twisted-builds-llc/sloppy_holley_flex-over-can/Sloppy_Holley_Flex-over-can/Flex-over-can/production/bom.csv

Designator | Footprint | Quantity | Value | LCSC Part #
C1 | 1206 | 1 | 10uF 50V | C13585
C10, C12, C13, C20, C21, C22, C23, C24, C30, C31, C32, C33 | 0603 | 12 | 100nF | C14663
C11, C7 | 0603 | 2 | 1uF | C15849
C14 | 0603 | 1 | 1nF | C1588
C2, C3 | 0805 | 2 | 0.1uF | C49678
C4 | CP_EIA-3528-21_Kemet-B | 1 | 47uF | C136751
C5 | 0805 | 1 | 1uF 50V | C28323
C6 | 0805 | 1 | 2.2uF 50V | C377773
C8, C9 | 0603 | 2 | 10uF | C19702
D1 | D_SMA | 1 | B160-13-F | C24784
D10, D11, D12, D13, D7 | SOT-23 | 5 | BAT54S | C7420333
D2 | D_SMB | 1 | 1SMB5919BT3G | C70260
D4 | D_SOD-123 | 1 | B5819W | C2943878
D5 | 0603 | 1 | STATUS | C2286
D6 | SOT-23 | 1 | NUP2105L | C284104
F2 | 1812 | 1 | PTC 0.2A 60V | C269125
J2 | USB_C_Receptacle_HRO_TYPE-C-31-M-12 | 1 | USB-C | C165948
JP1 | SolderJumper-2_P1.3mm_Open_RoundedPad1.0x1.5mm | 1 | CAN_TERM
NT1 | NetTie-2_SMD_Pad0.5mm | 1 | NetTie_2
R10, R15, R4, R5, R6 | 0603 | 5 | 10k | C25804
R11 | 0603 | 1 | 120 | C22787
R12, R13 | 0603 | 2 | 5.1k | C23186
R14, R8, R9 | 0603 | 3 | 4.7k | C23162
R20, R21, R22, R23 | 0603 | 4 | 12k | C22790
R24, R25, R26, R27 | 0603 | 4 | 20k | C4184
R30, R31, R32, R33 | 0603 | 4 | 3.3k | C22978
R34, R35, R36, R37 | 0603 | 4 | 100k | C25803
R7 | 0603 | 1 | 1k | C21190
RV1 | D_SMC | 1 | SMDJ24CA | C215903
SW1 | SW_Push_1P1T_XKB_TS-1187A | 1 | BOOT | C318884
U1 | ESP32-C3-WROOM-02 | 1 | ESP32-C3-WROOM-02-N4 | C2934560
U10 | TSSOP-10_3x3mm_P0.5mm | 1 | ADS1115IDGSR | C37593
U11 | SOT-23-5 | 1 | ME6211C33M5G-N | C82942
U2 | TO-263-2 | 1 | L7805ABD2T-TR | C86206
U3 | SOT-223 | 1 | TPS7B6950QDCYRQ1 | C108469
U4, U5, U6, U7 | TO-252-5_TabPin6 | 4 | BTS3256D | C3232337
U8 | SOIC-8_3.9x4.9mm_P1.27mm | 1 | TJA1051T/3 | C38695
U9 | SOT-23-6 | 1 | USBLC6-2SC6 | C7519
