twisted-builds-llc/sloppy_holley_flex-over-can/Sloppy_Holley_Flex-over-can/Flex-over-can/Flex-over-can_3D_file.step

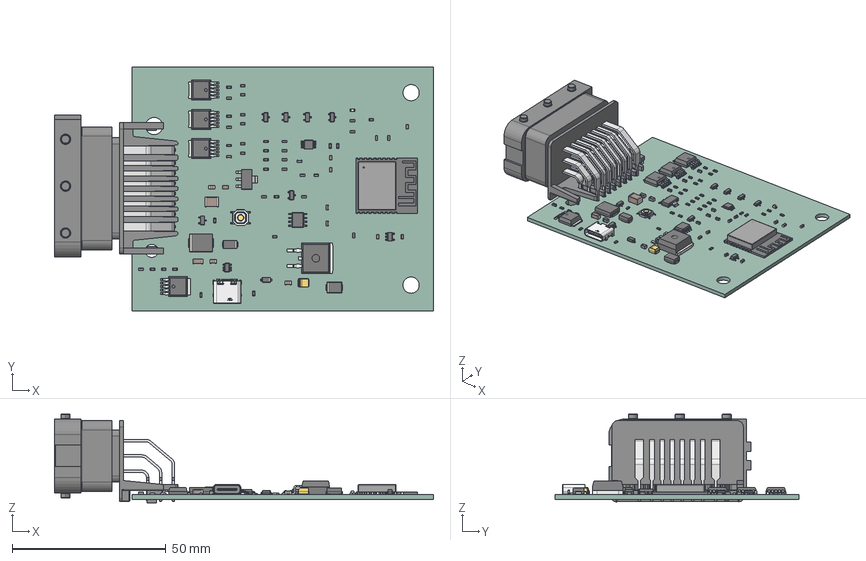
[picture p1: CAD file, 2026-10-27]
Sloppy_Holley_Flex-over-can/Flex-over-can/Flex-over-can_3D_file.step
123.3 x 79.5 x 29.0 mm
TSSOP-10_3x3mm_P0.5mm
C_0805_2012Metric x 4
C_0603_1608Metric x 17
R_0603_1608Metric x 32
SOT-23 x 6
CP_EIA_3528_21_Kemet_B
SOIC-8_3.9x4.9mm_P1.27mm
9e9c6de3-9c39-11ed-93f0-dde97e994e83_part x 4
9e9c6de4-9c39-11ed-93f0-dde97e994e83_part x 4
9e9c6de5-9c39-11ed-93f0-dde97e994e83_part x 4
SW-SMD_4P-L5.1-W5.1-P3.70-LS6.5-TL_H1.5
a3dd6ad7-9c39-11ed-93f0-dde97e994e83_part
a3dd6ad8-9c39-11ed-93f0-dde97e994e83_part
a3dd6ad9-9c39-11ed-93f0-dde97e994e83_part
ESP32-C3-WROOM-02
D_SMC
HCCPHPE24BKA90F
C_1206_3216Metric
USB-C_SMD-TYPE-C-31-M-12
D_SOD-123
SOT-223
C_1812_4532Metric
D_SMB
D_SMA
LED_0603_1608Metric
SOT-23-6
SOT-23-5
Flex-over-can-unsaved-export-QWINGS_PCB
