twisted-builds-llc/sloppy_holley_flex-over-can/Sloppy_Holley_Flex-over-can/Kicad-specific-libraries/3dmodels/HCCPHPE24BKA90F.step

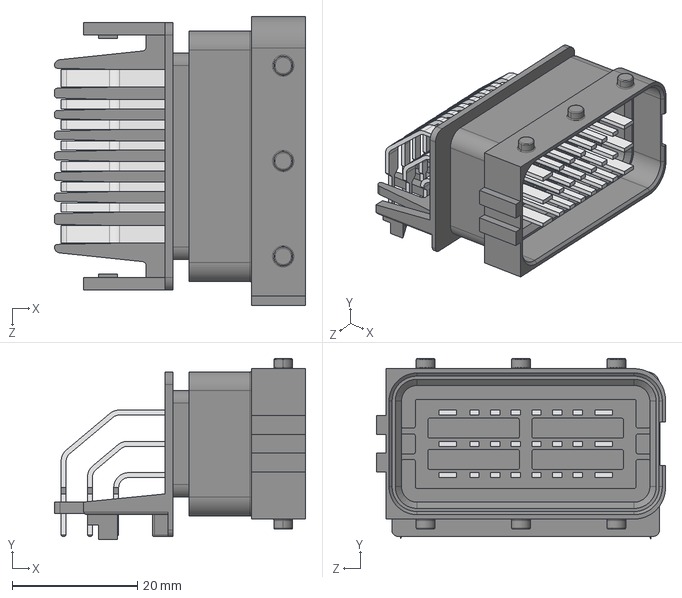
[picture p2: CAD file, 2026-10-23]
Sloppy_Holley_Flex-over-can/Kicad-specific-libraries/3dmodels/HCCPHPE24BKA90F.step
40.2 x 29.0 x 46.2 mm
