twisted-builds-llc/sloppy_holley_flex-over-can/(list of files, drawings)

Other design files:
Sloppy_Holley_Flex-over-can/Flex-over-can/Flex-over-canDSN2.dsn
Sloppy_Holley_Flex-over-can/Flex-over-can/Flex-over-canDSN.dsn
