twisted-builds-llc/sloppy_holley_flex-over-can/Sloppy_Holley_Flex-over-can/Flex-over-can/Flex-over-can.kicad_pcb

## KiCad design Sloppy_Holley_Flex-over-can/Flex-over-can/Flex-over-can.kicad_pcb (2026-11-01)

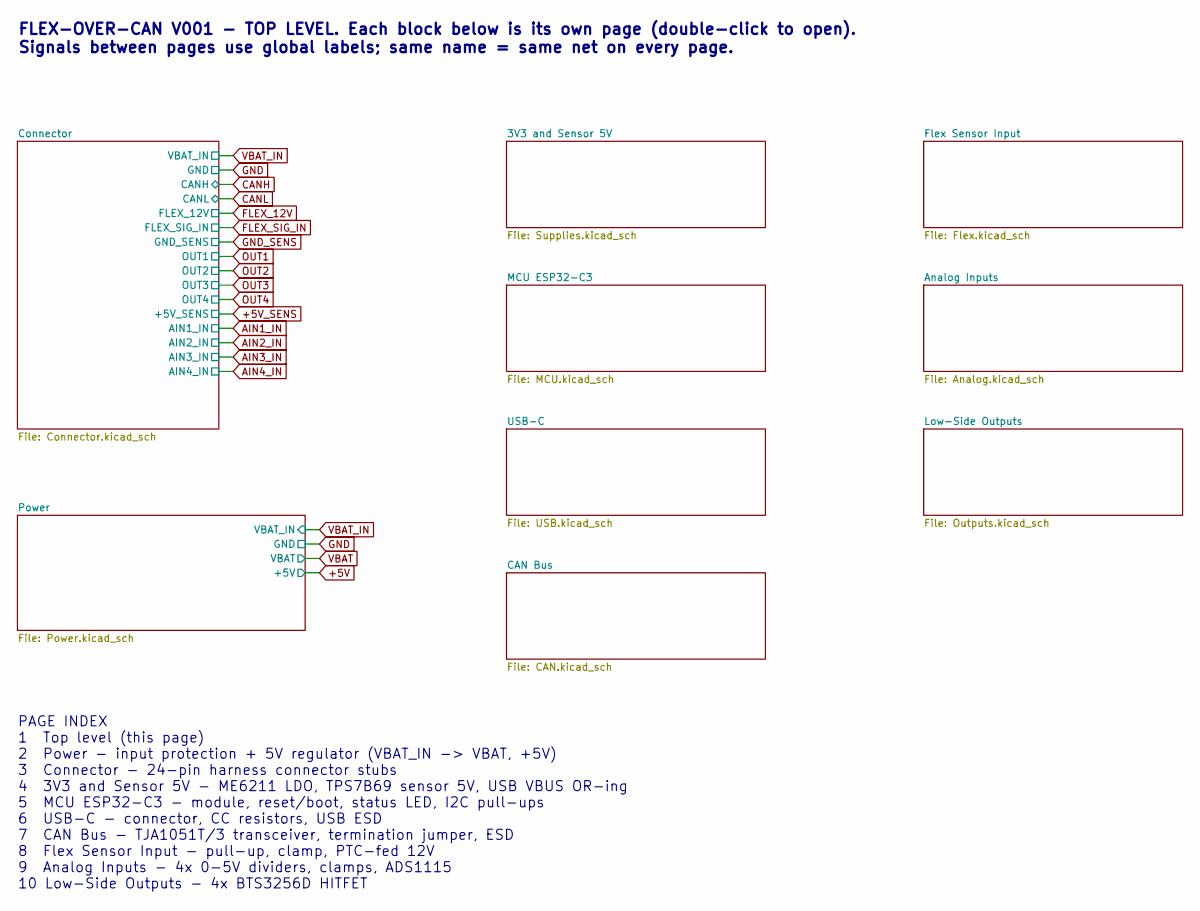
[picture p3: schematic Flex-over-can.kicad_sch, Flex-over-canbus]

Notes on the sheet:
PAGE INDEX 1 Top level (this page) 2 Power - input protection + 5V regulator (VBAT_IN -> VBAT, +5V) 3 Connector - 24-pin harness connector stubs 4 3V3 and Sensor 5V - ME6211 LDO, TPS7B69 sensor 5V, USB VBUS OR-ing 5 MCU ESP32-C3 - module, reset/boot, status LED, I2C pull-ups 6 USB-C - connector, CC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
FLEX-OVER-CAN V001 - TOP LEVEL. Each block below is its own page (double-click to open). Signals between pages use global labels; same name = same net on every page.

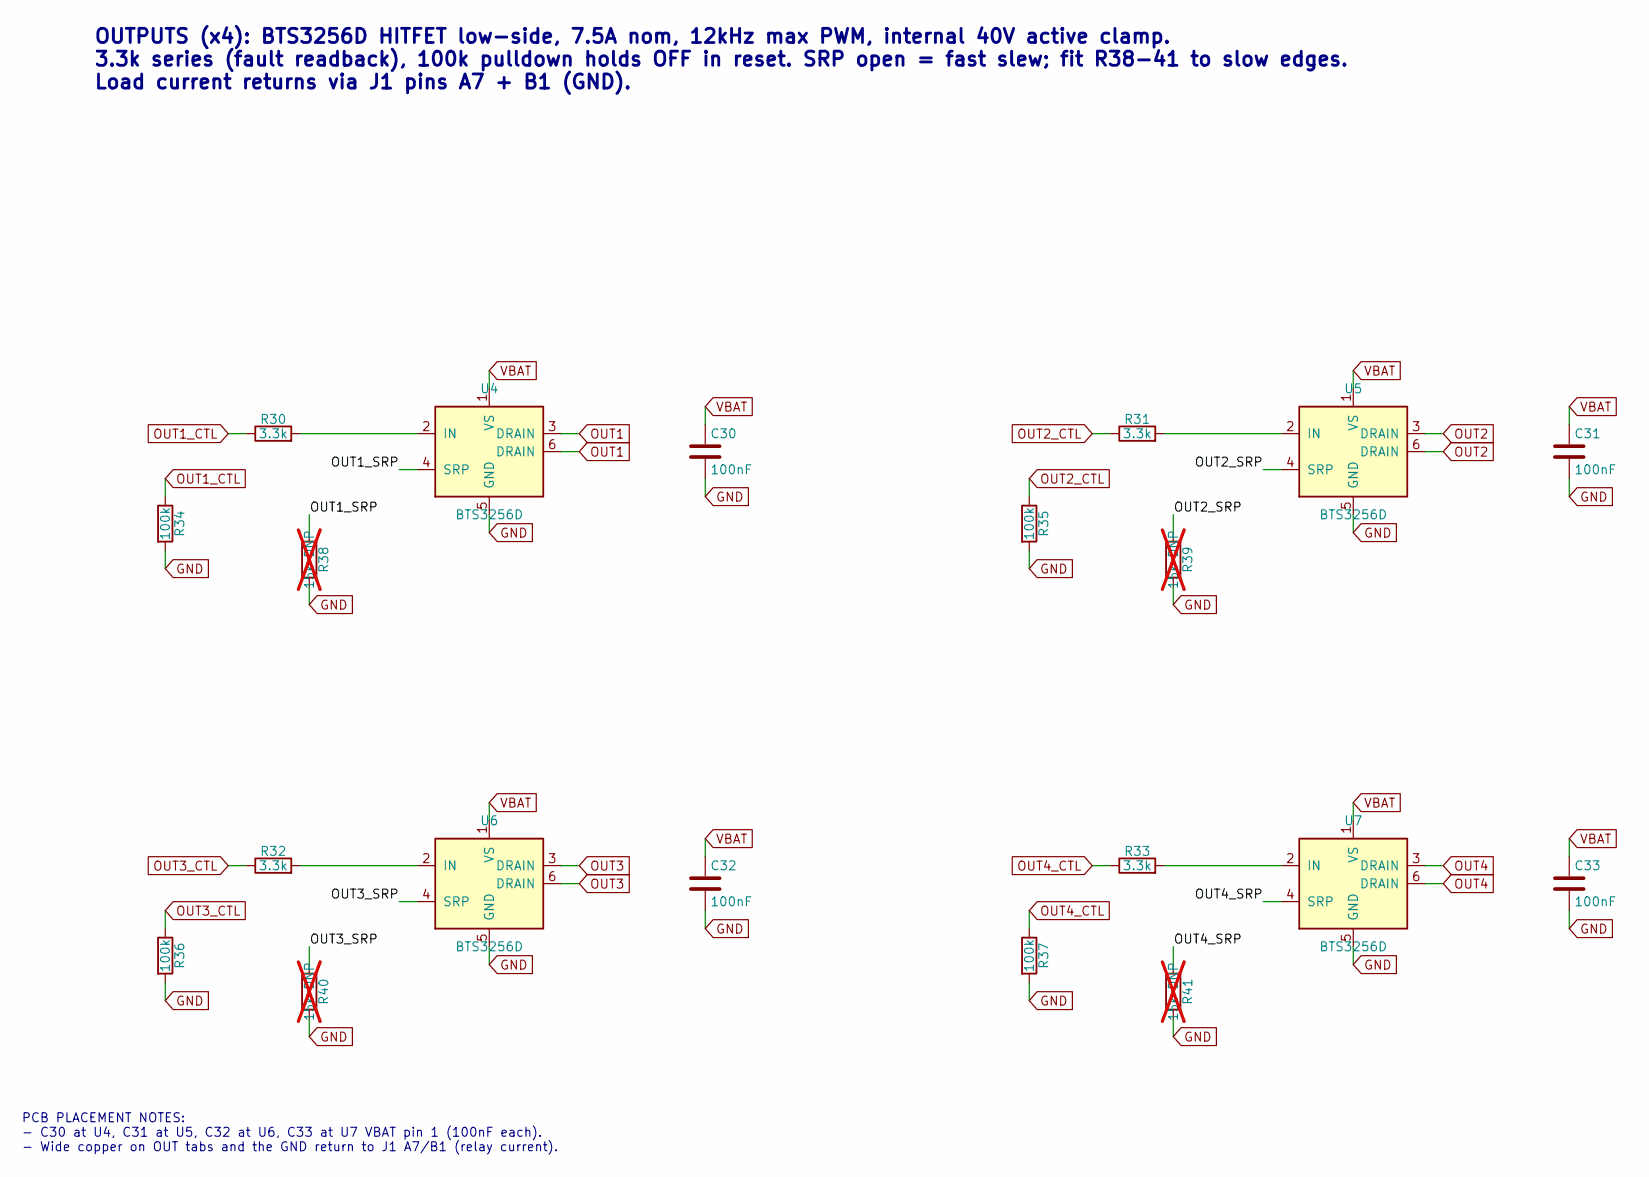
[picture p4: schematic Outputs.kicad_sch]

Parts:
C30, C31, C32, C33: 100nF; C_0603_1608Metric; LCSC C14663
R30, R31, R32, R33: 3.3k; R_0603_1608Metric; LCSC C22978
R34, R35, R36, R37: 100k; R_0603_1608Metric; LCSC C25803
R38, R39, R40, R41: 15k DNP; R_0603_1608Metric; LCSC C22809; not fitted
U4, U5, U6, U7: BTS3256D; TO-252-5_TabPin6; LCSC C3232337

Connections:
/Low-Side Outputs/OUT1_SRP: R38.1, U4.4 (SRP)
/Low-Side Outputs/OUT2_SRP: R39.1, U5.4 (SRP)
/Low-Side Outputs/OUT3_SRP: R40.1, U6.4 (SRP)
/Low-Side Outputs/OUT4_SRP: R41.1, U7.4 (SRP)
GND: C30.2, C31.2, C32.2, C33.2, R34.2, R35.2, R36.2, R37.2, R38.2, R39.2, R40.2, R41.2, U4.5 (GND), U5.5 (GND), U6.5 (GND), U7.5 (GND); also elsewhere on the board
unnamed: R30.2, U4.2 (IN)
unnamed: R31.2, U5.2 (IN)
unnamed: R32.2, U6.2 (IN)
unnamed: R33.2, U7.2 (IN)
OUT1: U4.3 (DRAIN), U4.6 (DRAIN); also elsewhere on the board
OUT1_CTL: R30.1, R34.1; also elsewhere on the board
OUT2: U5.3 (DRAIN), U5.6 (DRAIN); also elsewhere on the board
OUT2_CTL: R31.1, R35.1; also elsewhere on the board
OUT3: U6.3 (DRAIN), U6.6 (DRAIN); also elsewhere on the board
OUT3_CTL: R32.1, R36.1; also elsewhere on the board
OUT4: U7.3 (DRAIN), U7.6 (DRAIN); also elsewhere on the board
OUT4_CTL: R33.1, R37.1; also elsewhere on the board
VBAT: C30.1, C31.1, C32.1, C33.1, U4.1 (VS), U5.1 (VS), U6.1 (VS), U7.1 (VS); also elsewhere on the board

Notes on the sheet:
PCB PLACEMENT NOTES: - C30 at U4, C31 at U5, C32 at U6, C33 at U7 VBAT pin 1 (100nF each). - Wide copper on OUT tabs and the GND return to J1 A7/B1 (relay current).
OUTPUTS (x4): BTS3256D HITFET low-side, 7.5A nom, 12kHz max PWM, internal 40V active clamp. 3.3k series (fault readback), 100k pulldown holds OFF in reset. SRP open = fast slew; fit R38-41 to slow edges. Load current returns via J1 pins A7 + B1 (GND).

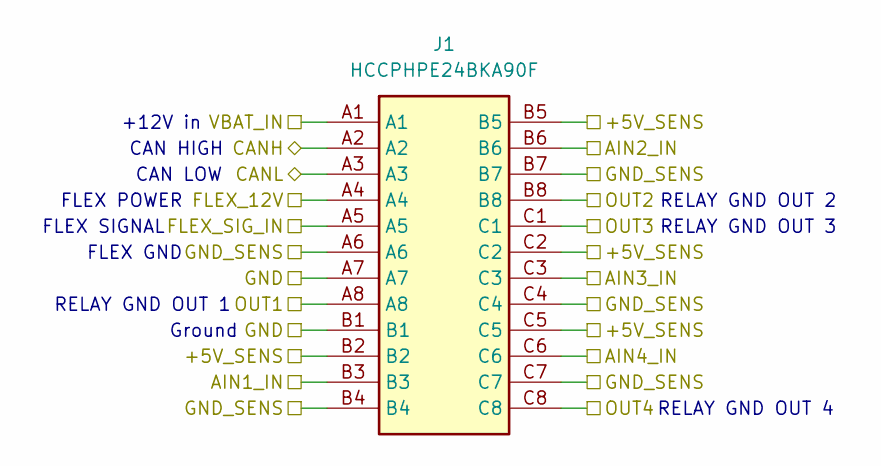
[picture p5: schematic Connector.kicad_sch]

Parts:
J1: HCCPHPE24BKA90F; 24pinConnectorFootprint; Manufacturer_Part_Number HCCPHPE24BKA90F; Mouser Part Number 649-HCCPHPE24BKA90F

Connections:
+5V_SENS: J1.B2, J1.B5, J1.C2, J1.C5; also elsewhere on the board
AIN1_IN: J1.B3; also elsewhere on the board
AIN2_IN: J1.B6; also elsewhere on the board
AIN3_IN: J1.C3; also elsewhere on the board
AIN4_IN: J1.C6; also elsewhere on the board
CANH: J1.A2; also elsewhere on the board
CANL: J1.A3; also elsewhere on the board
FLEX_12V: J1.A4; also elsewhere on the board
FLEX_SIG_IN: J1.A5; also elsewhere on the board
GND: J1.A7, J1.B1; also elsewhere on the board
GND_SENS: J1.A6, J1.B4, J1.B7, J1.C4, J1.C7; also elsewhere on the board
OUT1: J1.A8; also elsewhere on the board
OUT2: J1.B8; also elsewhere on the board
OUT3: J1.C1; also elsewhere on the board
OUT4: J1.C8; also elsewhere on the board
VBAT_IN: J1.A1; also elsewhere on the board

Notes on the sheet:
FLEX SIGNAL
RELAY GND OUT 2
+12V in
FLEX GND
RELAY GND OUT 3
Ground
CAN HIGH
RELAY GND OUT 1
FLEX POWER
CAN LOW
RELAY GND OUT 4

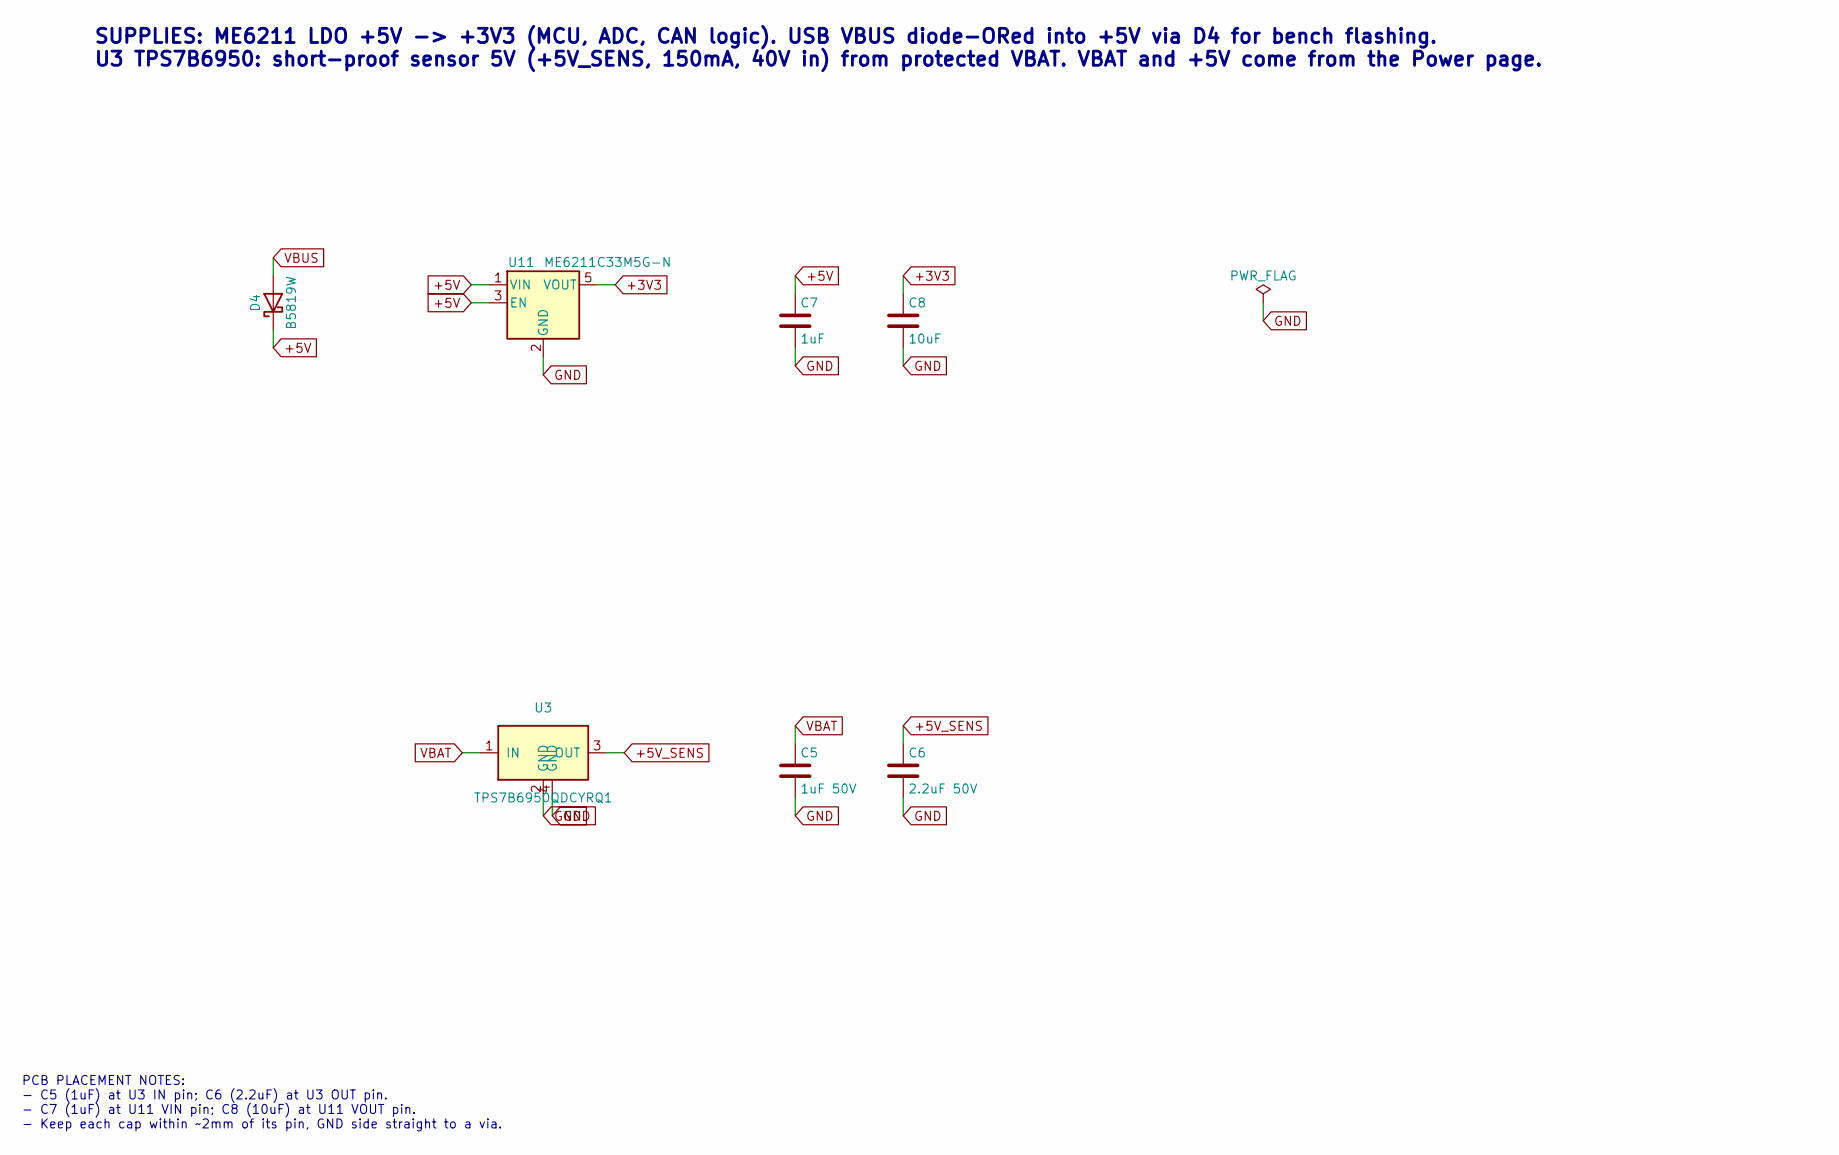
[picture p6: schematic Supplies.kicad_sch]

Parts:
C5: 1uF 50V; C_0805_2012Metric; LCSC C28323
C6: 2.2uF 50V; C_0805_2012Metric; LCSC C377773
C7: 1uF; C_0603_1608Metric; LCSC C15849
C8: 10uF; C_0603_1608Metric; LCSC C19702
D4: B5819W; D_SOD-123; LCSC C2943878
U3: TPS7B6950QDCYRQ1; SOT-223; LCSC C108469
U11: ME6211C33M5G-N; SOT-23-5; LCSC C82942

Connections:
+3V3: C8.1, U11.5 (VOUT); also elsewhere on the board
+5V: C7.1, D4.1 (K), U11.1 (VIN), U11.3 (EN); also elsewhere on the board
+5V_SENS: C6.1, U3.3 (OUT); also elsewhere on the board
GND: C5.2, C6.2, C7.2, C8.2, U3.2 (GND), U3.4 (GND), U11.2 (GND); also elsewhere on the board
VBAT: C5.1, U3.1 (IN); also elsewhere on the board
VBUS: D4.2 (A); also elsewhere on the board

Notes on the sheet:
PCB PLACEMENT NOTES: - C5 (1uF) at U3 IN pin; C6 (2.2uF) at U3 OUT pin. - C7 (1uF) at U11 VIN pin; C8 (10uF) at U11 VOUT pin. - Keep each cap within ~2mm of its pin, GND side straight to a via.
SUPPLIES: ME6211 LDO +5V -> +3V3 (MCU, ADC, CAN logic). USB VBUS diode-ORed into +5V via D4 for bench flashing. U3 TPS7B6950: short-proof sensor 5V (+5V_SENS, 150mA, 40V in) from protected VBAT. VBAT and +5V come from the Power page.

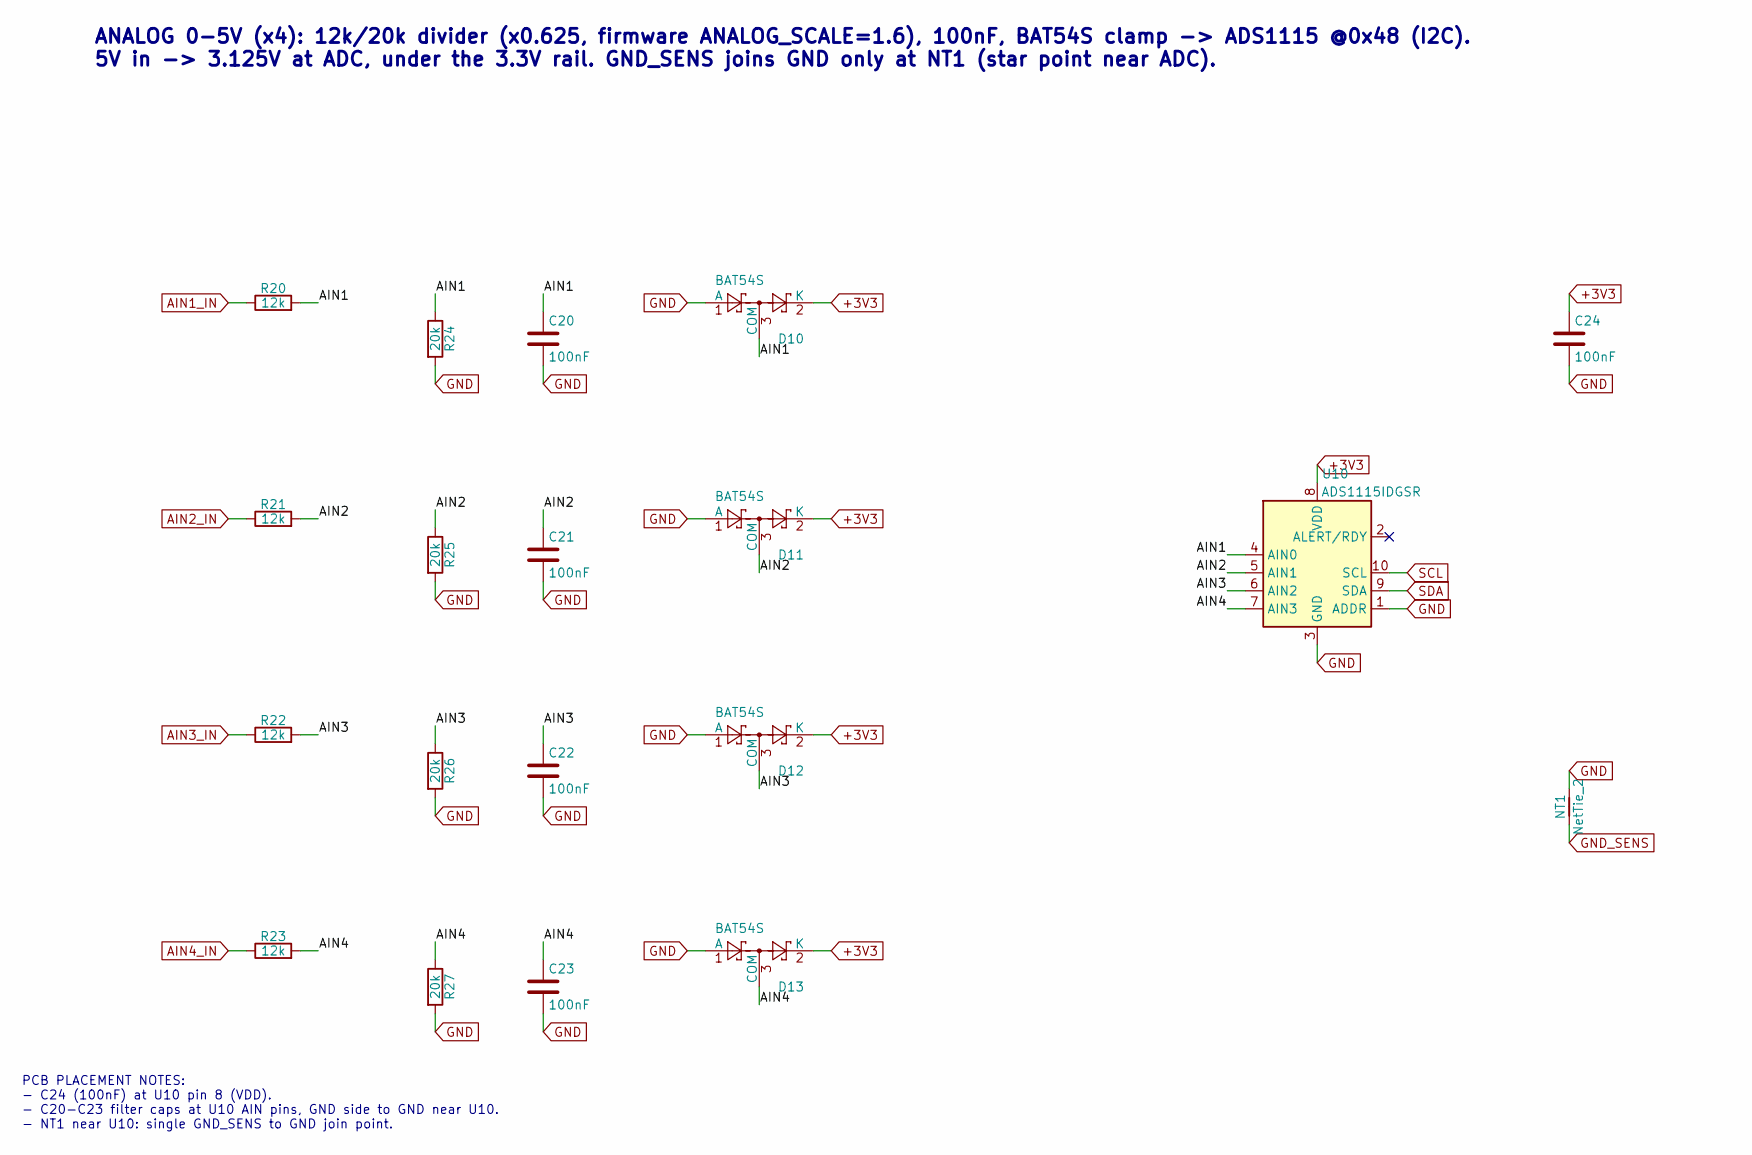
[picture p7: schematic Analog.kicad_sch]

Parts:
C20, C21, C22, C23, C24: 100nF; C_0603_1608Metric; LCSC C14663
D10, D11, D12, D13: BAT54S; SOT-23; LCSC C7420333
NT1: NetTie_2; NetTie-2_SMD_Pad0.5mm
R20, R21, R22, R23: 12k; R_0603_1608Metric; LCSC C22790
R24, R25, R26, R27: 20k; R_0603_1608Metric; LCSC C4184
U10: ADS1115IDGSR; TSSOP-10_3x3mm_P0.5mm; LCSC C37593

Connections:
+3V3: C24.1, D10.2 (K), D11.2 (K), D12.2 (K), D13.2 (K), U10.8 (VDD); also elsewhere on the board
/Analog Inputs/AIN1: C20.1, D10.3 (COM), R20.2, R24.1, U10.4 (AIN0)
/Analog Inputs/AIN2: C21.1, D11.3 (COM), R21.2, R25.1, U10.5 (AIN1)
/Analog Inputs/AIN3: C22.1, D12.3 (COM), R22.2, R26.1, U10.6 (AIN2)
/Analog Inputs/AIN4: C23.1, D13.3 (COM), R23.2, R27.1, U10.7 (AIN3)
AIN1_IN: R20.1; also elsewhere on the board
AIN2_IN: R21.1; also elsewhere on the board
AIN3_IN: R22.1; also elsewhere on the board
AIN4_IN: R23.1; also elsewhere on the board
GND: C20.2, C21.2, C22.2, C23.2, C24.2, D10.1 (A), D11.1 (A), D12.1 (A), D13.1 (A), NT1.2, R24.2, R25.2, R26.2, R27.2, U10.1 (ADDR), U10.3 (GND); also elsewhere on the board
GND_SENS: NT1.1; also elsewhere on the board
SCL: U10.10 (SCL); also elsewhere on the board
SDA: U10.9 (SDA); also elsewhere on the board

Notes on the sheet:
ANALOG 0-5V (x4): 12k/20k divider (x0.625, firmware ANALOG_SCALE=1.6), 100nF, BAT54S clamp -> ADS1115 @0x48 (I2C). 5V in -> 3.125V at ADC, under the 3.3V rail. GND_SENS joins GND only at NT1 (star point near ADC).
PCB PLACEMENT NOTES: - C24 (100nF) at U10 pin 8 (VDD). - C20-C23 filter caps at U10 AIN pins, GND side to GND near U10. - NT1 near U10: single GND_SENS to GND join point.

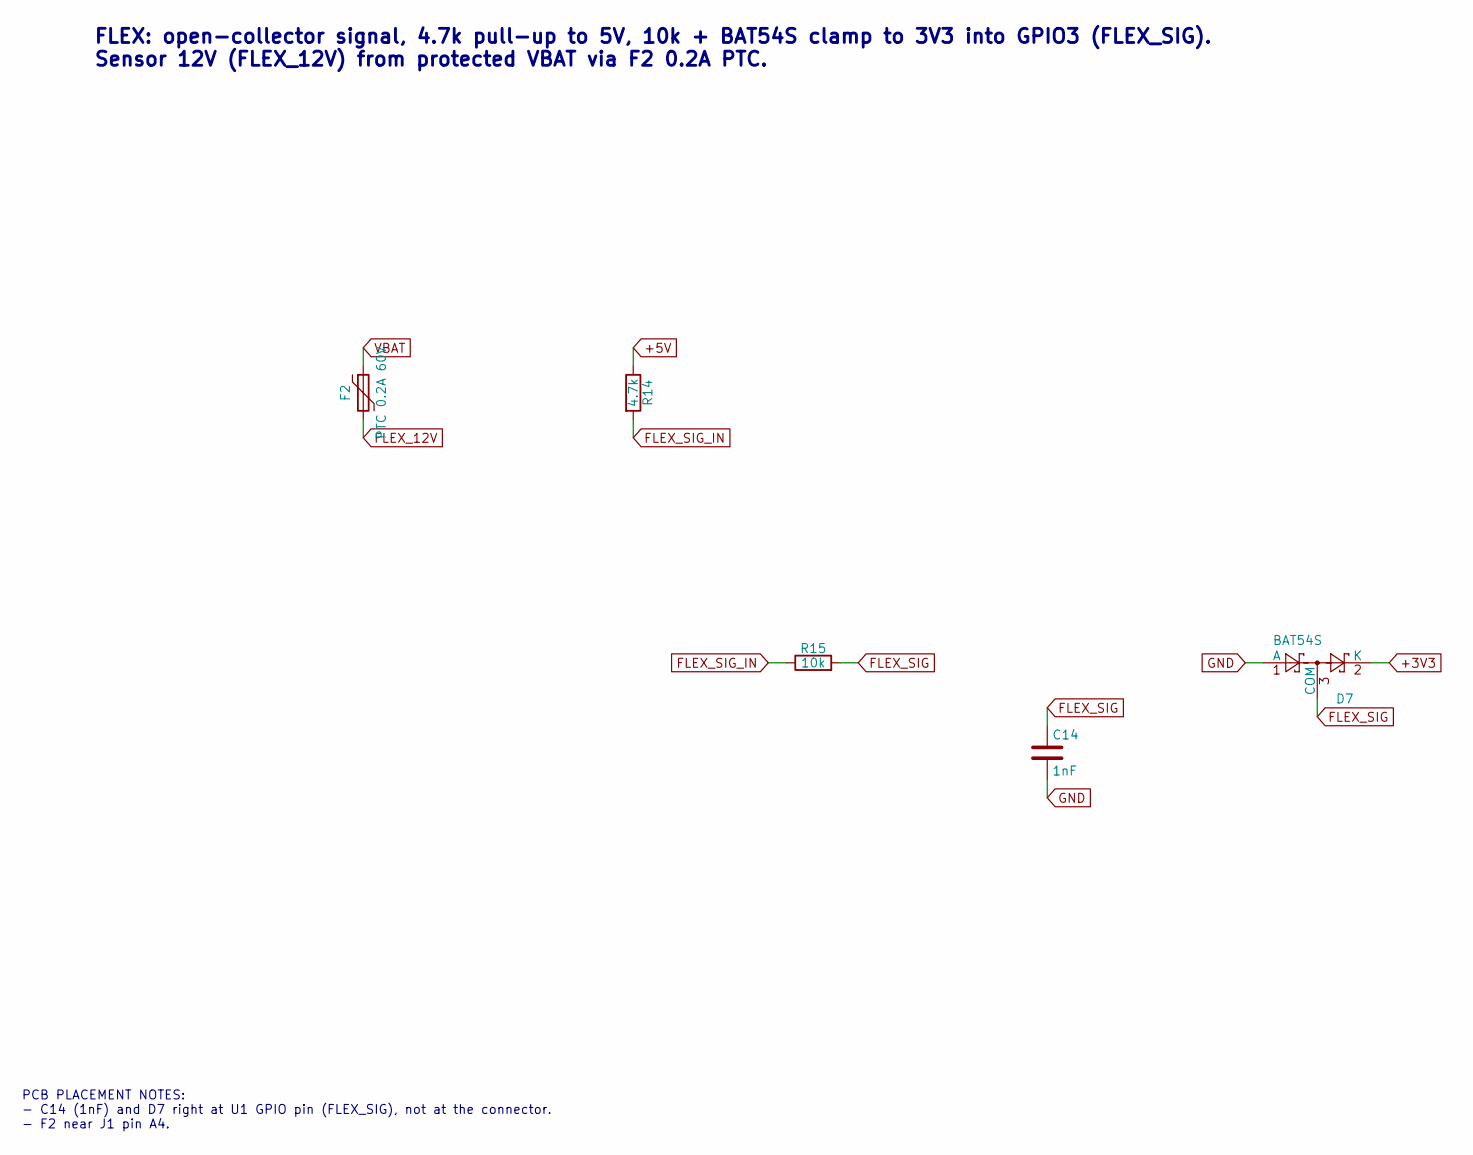
[picture p8: schematic Flex.kicad_sch]

Parts:
C14: 1nF; C_0603_1608Metric; LCSC C1588
D7: BAT54S; SOT-23; LCSC C7420333
F2: PTC 0.2A 60V; Fuse_1812_4532Metric; MPN SMD1812B020TF-J; LCSC C269125
R14: 4.7k; R_0603_1608Metric; LCSC C23162
R15: 10k; R_0603_1608Metric; LCSC C25804

Connections:
+3V3: D7.2 (K); also elsewhere on the board
+5V: R14.1; also elsewhere on the board
FLEX_12V: F2.2; also elsewhere on the board
FLEX_SIG: C14.1, D7.3 (COM), R15.2; also elsewhere on the board
FLEX_SIG_IN: R14.2, R15.1; also elsewhere on the board
GND: C14.2, D7.1 (A); also elsewhere on the board
VBAT: F2.1; also elsewhere on the board

Notes on the sheet:
FLEX: open-collector signal, 4.7k pull-up to 5V, 10k + BAT54S clamp to 3V3 into GPIO3 (FLEX_SIG). Sensor 12V (FLEX_12V) from protected VBAT via F2 0.2A PTC.
PCB PLACEMENT NOTES: - C14 (1nF) and D7 right at U1 GPIO pin (FLEX_SIG), not at the connector. - F2 near J1 pin A4.

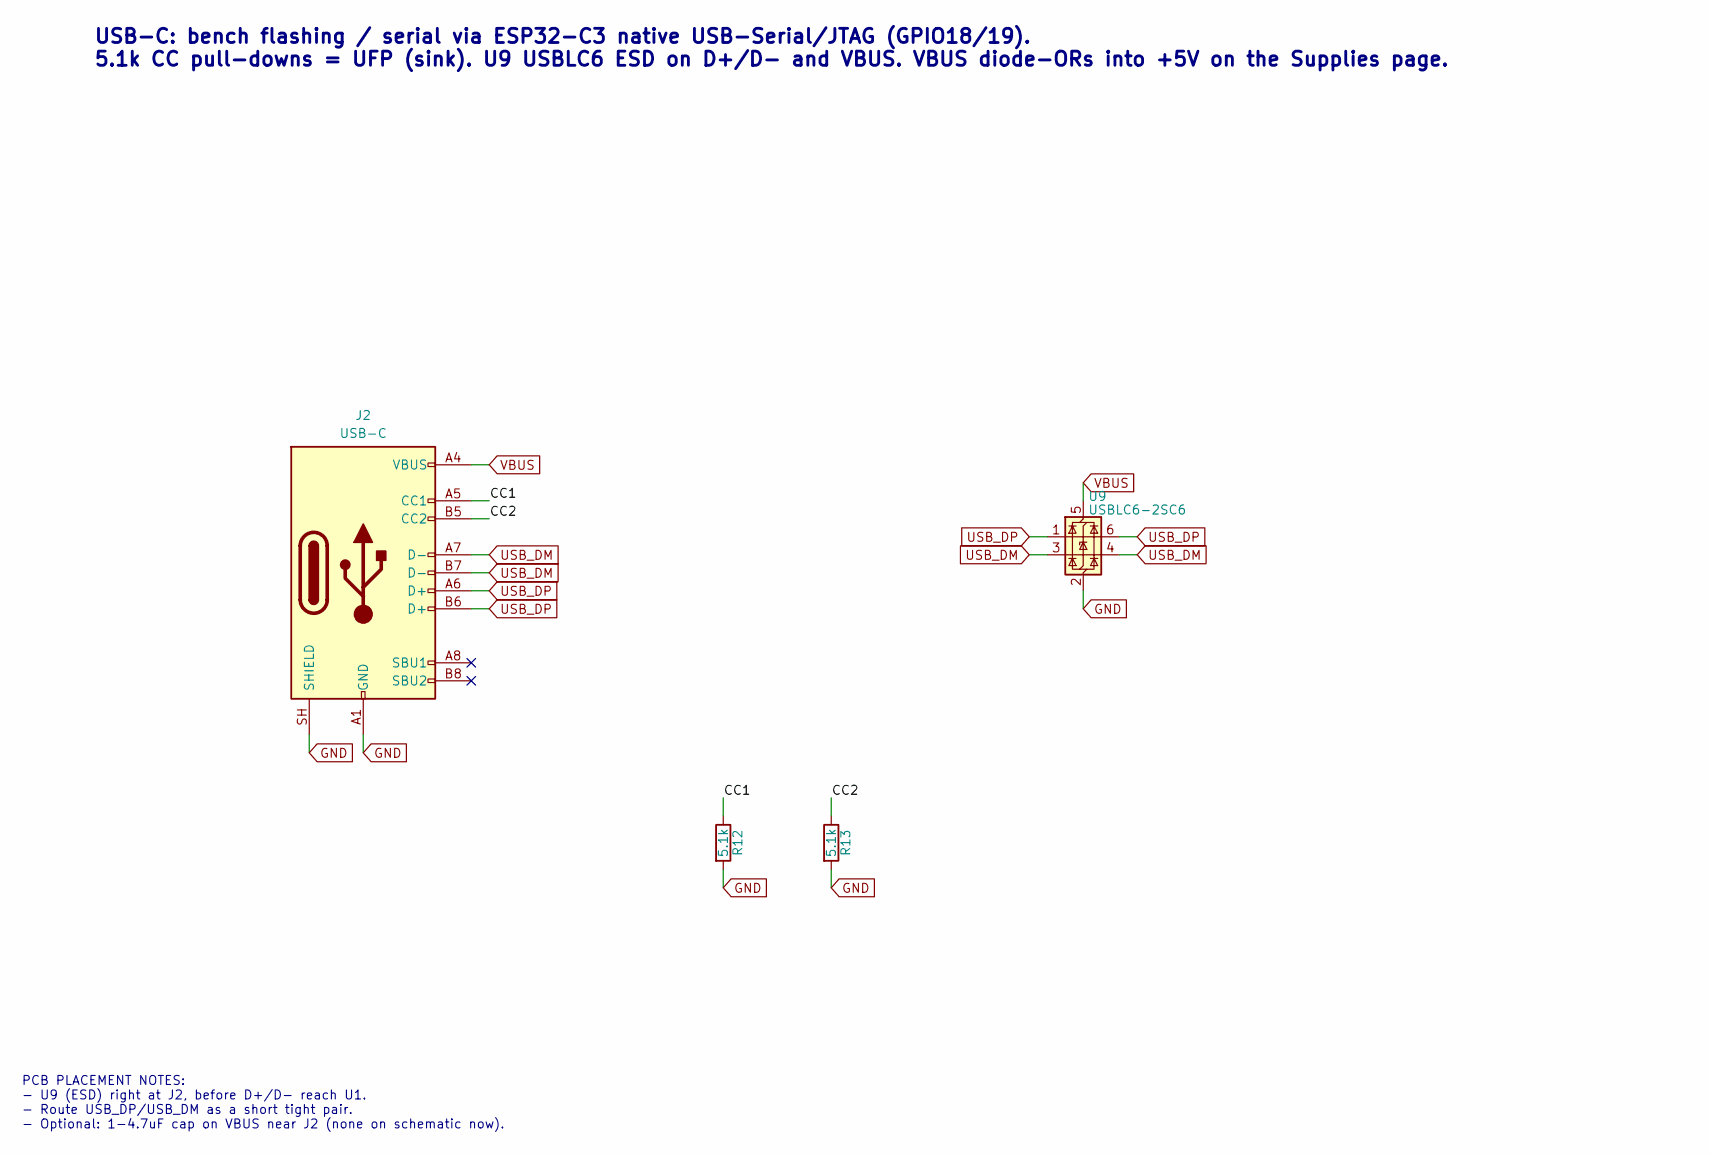
[picture p9: schematic USB.kicad_sch]

Parts:
J2: USB-C; USB_C_Receptacle_HRO_TYPE-C-31-M-12; LCSC C165948
R12, R13: 5.1k; R_0603_1608Metric; LCSC C23186
U9: USBLC6-2SC6; SOT-23-6; LCSC C7519

Connections:
/USB-C/CC1: J2.A5 (CC1), R12.1
/USB-C/CC2: J2.B5 (CC2), R13.1
GND: J2.A1 (GND), J2.A12 (GND), J2.B1 (GND), J2.B12 (GND), J2.SH (SHIELD), R12.2, R13.2, U9.2 (GND); also elsewhere on the board
USB_DM: J2.A7 (D-), J2.B7 (D-), U9.3 (I/O2), U9.4 (I/O2); also elsewhere on the board
USB_DP: J2.A6 (D+), J2.B6 (D+), U9.1 (I/O1), U9.6 (I/O1); also elsewhere on the board
VBUS: J2.A4 (VBUS), J2.A9 (VBUS), J2.B4 (VBUS), J2.B9 (VBUS), U9.5 (VBUS); also elsewhere on the board

Notes on the sheet:
PCB PLACEMENT NOTES: - U9 (ESD) right at J2, before D+/D- reach U1. - Route USB_DP/USB_DM as a short tight pair. - Optional: 1-4.7uF cap on VBUS near J2 (none on schematic now).
USB-C: bench flashing / serial via ESP32-C3 native USB-Serial/JTAG (GPIO18/19). 5.1k CC pull-downs = UFP (sink). U9 USBLC6 ESD on D+/D- and VBUS. VBUS diode-ORs into +5V on the Supplies page.

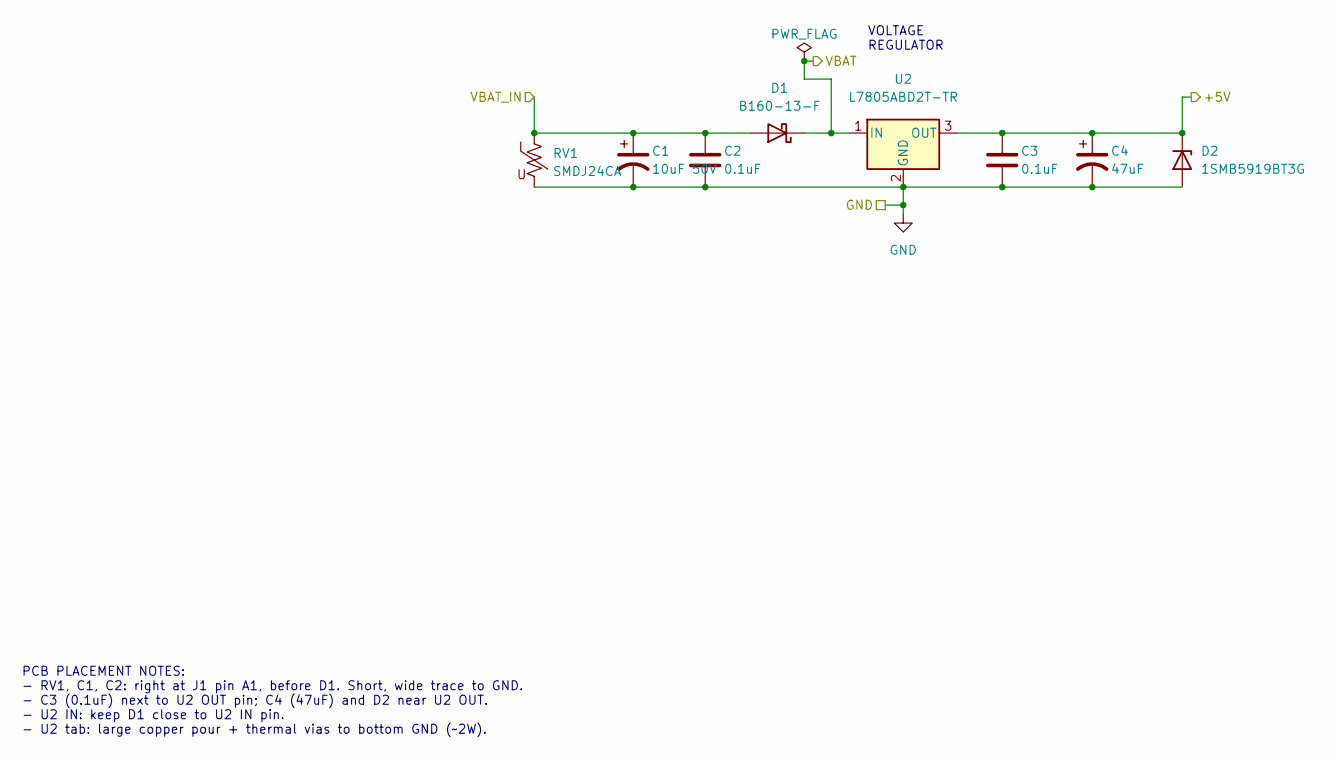
[picture p10: schematic Power.kicad_sch]

Parts:
C1: 10uF 50V; C_1206_3216Metric; LCSC C13585
C2, C3: 0.1uF; C_0805_2012Metric; LCSC C49678
C4: 47uF; CP_EIA-3528-21_Kemet-B; LCSC C136751
D1: B160-13-F; D_SMA; LCSC C24784
D2: 1SMB5919BT3G; D_SMB; LCSC C70260
RV1: SMDJ24CA; D_SMC; LCSC C215903
U2: L7805ABD2T-TR; TO-263-2; LCSC C86206

Connections:
+5V: C3.1, C4.1, D2.1 (K), U2.3 (OUT); also elsewhere on the board
GND: C1.2, C2.2, C3.2, C4.2, D2.2 (A), RV1.2, U2.2 (GND); also elsewhere on the board
VBAT: D1.1 (K), U2.1 (IN); also elsewhere on the board
VBAT_IN: C1.1, C2.1, D1.2 (A), RV1.1; also elsewhere on the board

Notes on the sheet:
PCB PLACEMENT NOTES: - RV1, C1, C2: right at J1 pin A1, before D1. Short, wide trace to GND. - C3 (0.1uF) next to U2 OUT pin; C4 (47uF) and D2 near U2 OUT. - U2 IN: keep D1 close to U2 IN pin. - U2 tab: large copper pour + thermal vias to bottom GND (~2W).
VOLTAGE REGULATOR

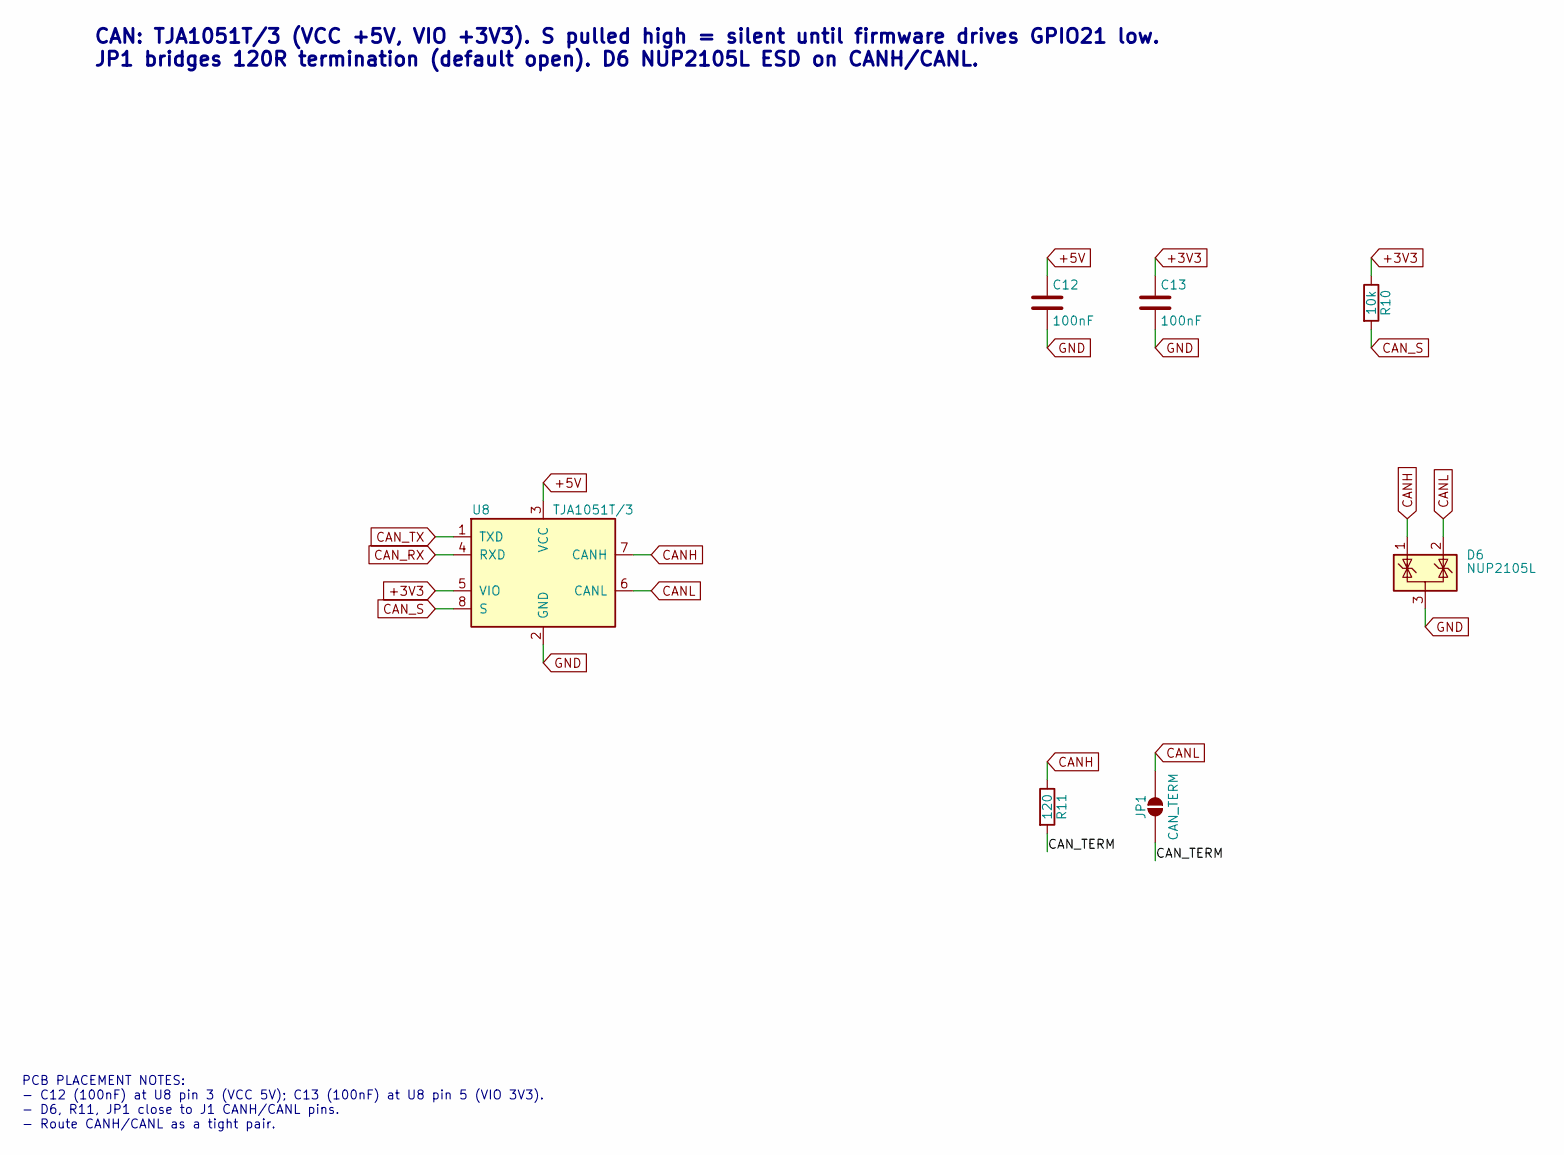
[picture p11: schematic CAN.kicad_sch]

Parts:
C12, C13: 100nF; C_0603_1608Metric; LCSC C14663
D6: NUP2105L; SOT-23; LCSC C284104
JP1: CAN_TERM; SolderJumper-2_P1.3mm_Open_RoundedPad1.0x1.5mm
R10: 10k; R_0603_1608Metric; LCSC C25804
R11: 120; R_0603_1608Metric; LCSC C22787
U8: TJA1051T/3; SOIC-8_3.9x4.9mm_P1.27mm; LCSC C38695

Connections:
+3V3: C13.1, R10.1, U8.5 (VIO); also elsewhere on the board
+5V: C12.1, U8.3 (VCC); also elsewhere on the board
/CAN Bus/CAN_TERM: JP1.1 (A), R11.2
CANH: D6.1 (K), R11.1, U8.7 (CANH); also elsewhere on the board
CANL: D6.2 (K), JP1.2 (B), U8.6 (CANL); also elsewhere on the board
CAN_RX: U8.4 (RXD); also elsewhere on the board
CAN_S: R10.2, U8.8 (S); also elsewhere on the board
CAN_TX: U8.1 (TXD); also elsewhere on the board
GND: C12.2, C13.2, D6.3 (A), U8.2 (GND); also elsewhere on the board

Notes on the sheet:
PCB PLACEMENT NOTES: - C12 (100nF) at U8 pin 3 (VCC 5V); C13 (100nF) at U8 pin 5 (VIO 3V3). - D6, R11, JP1 close to J1 CANH/CANL pins. - Route CANH/CANL as a tight pair.
CAN: TJA1051T/3 (VCC +5V, VIO +3V3). S pulled high = silent until firmware drives GPIO21 low. JP1 bridges 120R termination (default open). D6 NUP2105L ESD on CANH/CANL.

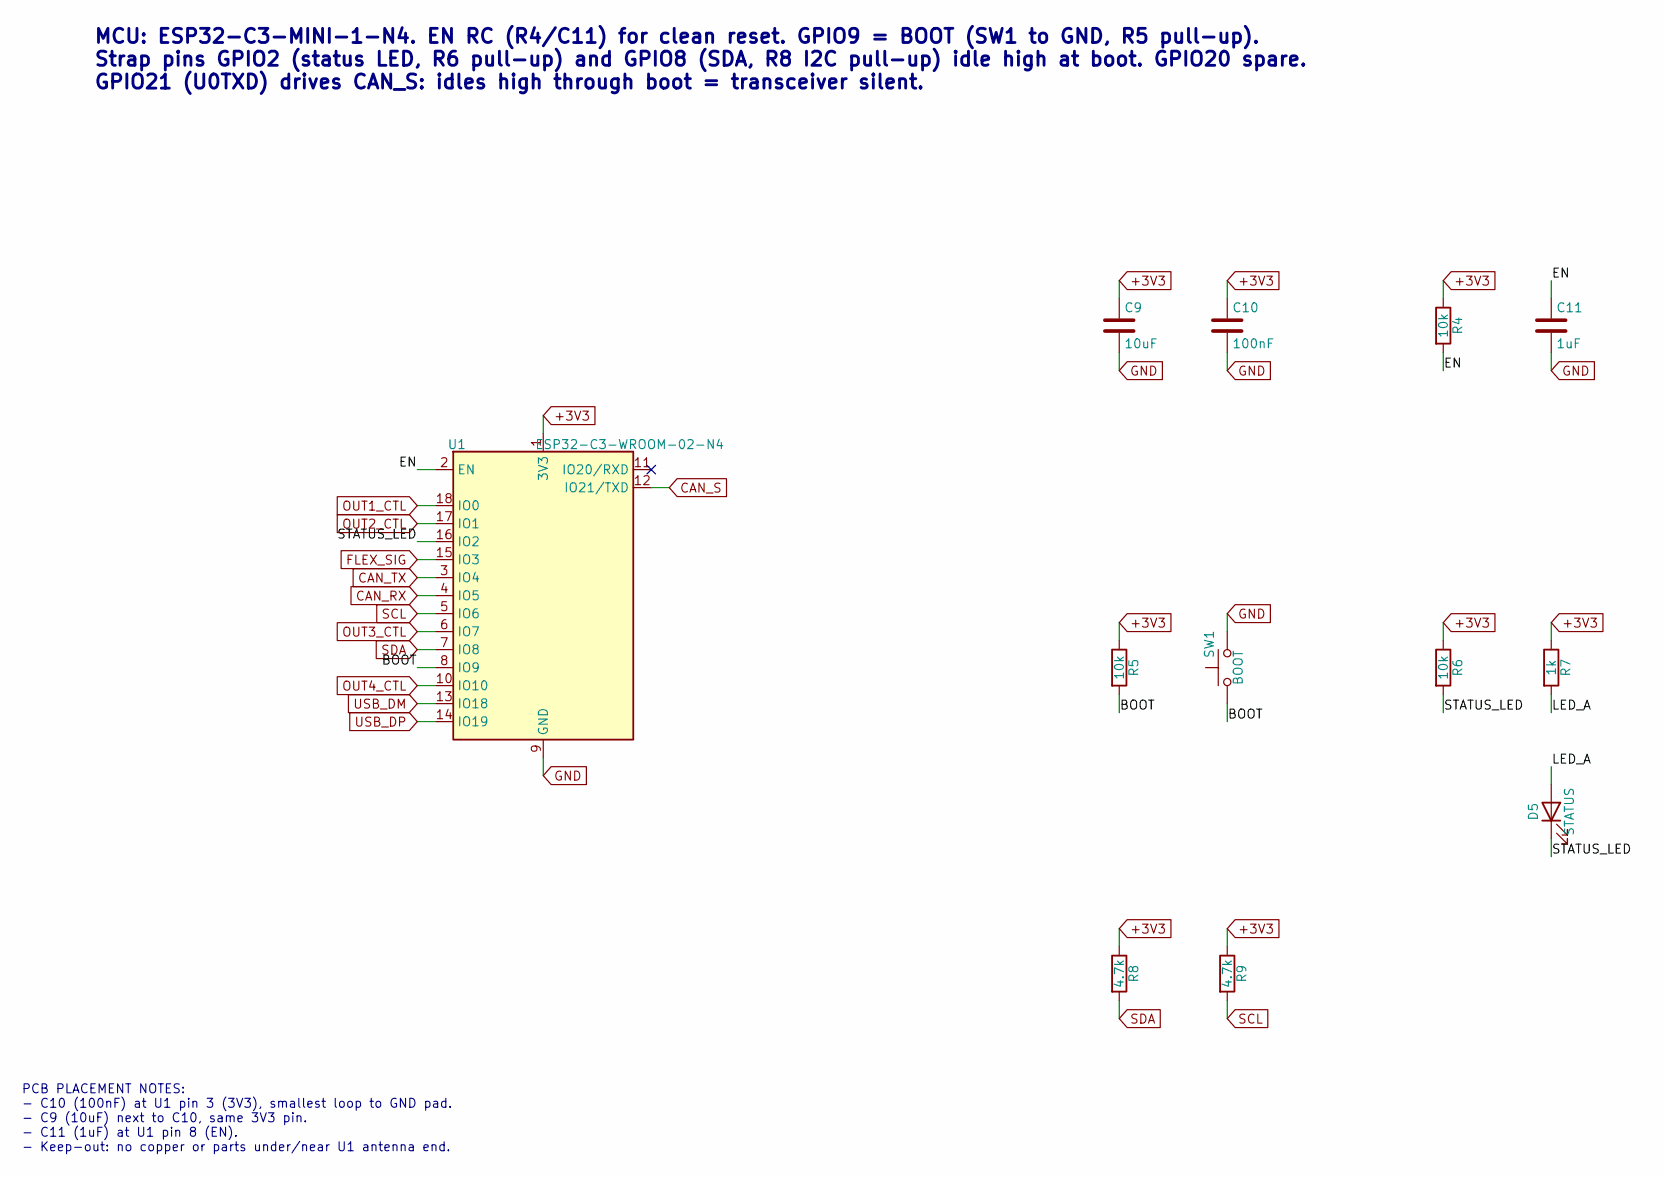
[picture p12: schematic MCU.kicad_sch]

Parts:
C9: 10uF; C_0603_1608Metric; LCSC C19702
C10: 100nF; C_0603_1608Metric; LCSC C14663
C11: 1uF; C_0603_1608Metric; LCSC C15849
D5: STATUS; LED_0603_1608Metric; LCSC C2286
R4, R5, R6: 10k; R_0603_1608Metric; LCSC C25804
R7: 1k; R_0603_1608Metric; LCSC C21190
R8, R9: 4.7k; R_0603_1608Metric; LCSC C23162
SW1: BOOT; SW_Push_1P1T_XKB_TS-1187A; LCSC C318884
U1: ESP32-C3-WROOM-02-N4; ESP32-C3-WROOM-02; LCSC C2934560

Connections:
+3V3: C9.1, C10.1, R4.1, R5.1, R6.1, R7.1, R8.1, R9.1, U1.1 (3V3); also elsewhere on the board
/MCU ESP32-C3/BOOT: R5.2, SW1.1, U1.8 (IO9)
/MCU ESP32-C3/EN: C11.1, R4.2, U1.2 (EN)
/MCU ESP32-C3/LED_A: D5.2 (A), R7.2
/MCU ESP32-C3/STATUS_LED: D5.1 (K), R6.2, U1.16 (IO2)
CAN_RX: U1.4 (IO5); also elsewhere on the board
CAN_S: U1.12 (IO21/TXD); also elsewhere on the board
CAN_TX: U1.3 (IO4); also elsewhere on the board
FLEX_SIG: U1.15 (IO3); also elsewhere on the board
GND: C9.2, C10.2, C11.2, SW1.2, U1.9 (GND), U1.19 (GND); also elsewhere on the board
OUT1_CTL: U1.18 (IO0); also elsewhere on the board
OUT2_CTL: U1.17 (IO1); also elsewhere on the board
OUT3_CTL: U1.6 (IO7); also elsewhere on the board
OUT4_CTL: U1.10 (IO10); also elsewhere on the board
SCL: R9.2, U1.5 (IO6); also elsewhere on the board
SDA: R8.2, U1.7 (IO8); also elsewhere on the board
USB_DM: U1.13 (IO18); also elsewhere on the board
USB_DP: U1.14 (IO19); also elsewhere on the board

Notes on the sheet:
PCB PLACEMENT NOTES: - C10 (100nF) at U1 pin 3 (3V3), smallest loop to GND pad. - C9 (10uF) next to C10, same 3V3 pin. - C11 (1uF) at U1 pin 8 (EN). - Keep-out: no copper or parts under/near U1 antenna end.
MCU: ESP32-C3-MINI-1-N4. EN RC (R4/C11) for clean reset. GPIO9 = BOOT (SW1 to GND, R5 pull-up). Strap pins GPIO2 (status LED, R6 pull-up) and GPIO8 (SDA, R8 I2C pull-up) idle high at boot. GPIO20 spare. GPIO21 (U0TXD) drives CAN_S: idles high through boot = transceiver silent.
