twisted-builds-llc/sloppy_holley_flex-over-can/Sloppy_Holley_Flex-over-can/Flex-over-can/Flex-over-can.kicad_pcb

## KiCad design Sloppy_Holley_Flex-over-can/Flex-over-can/Flex-over-can.kicad_pcb (continued)

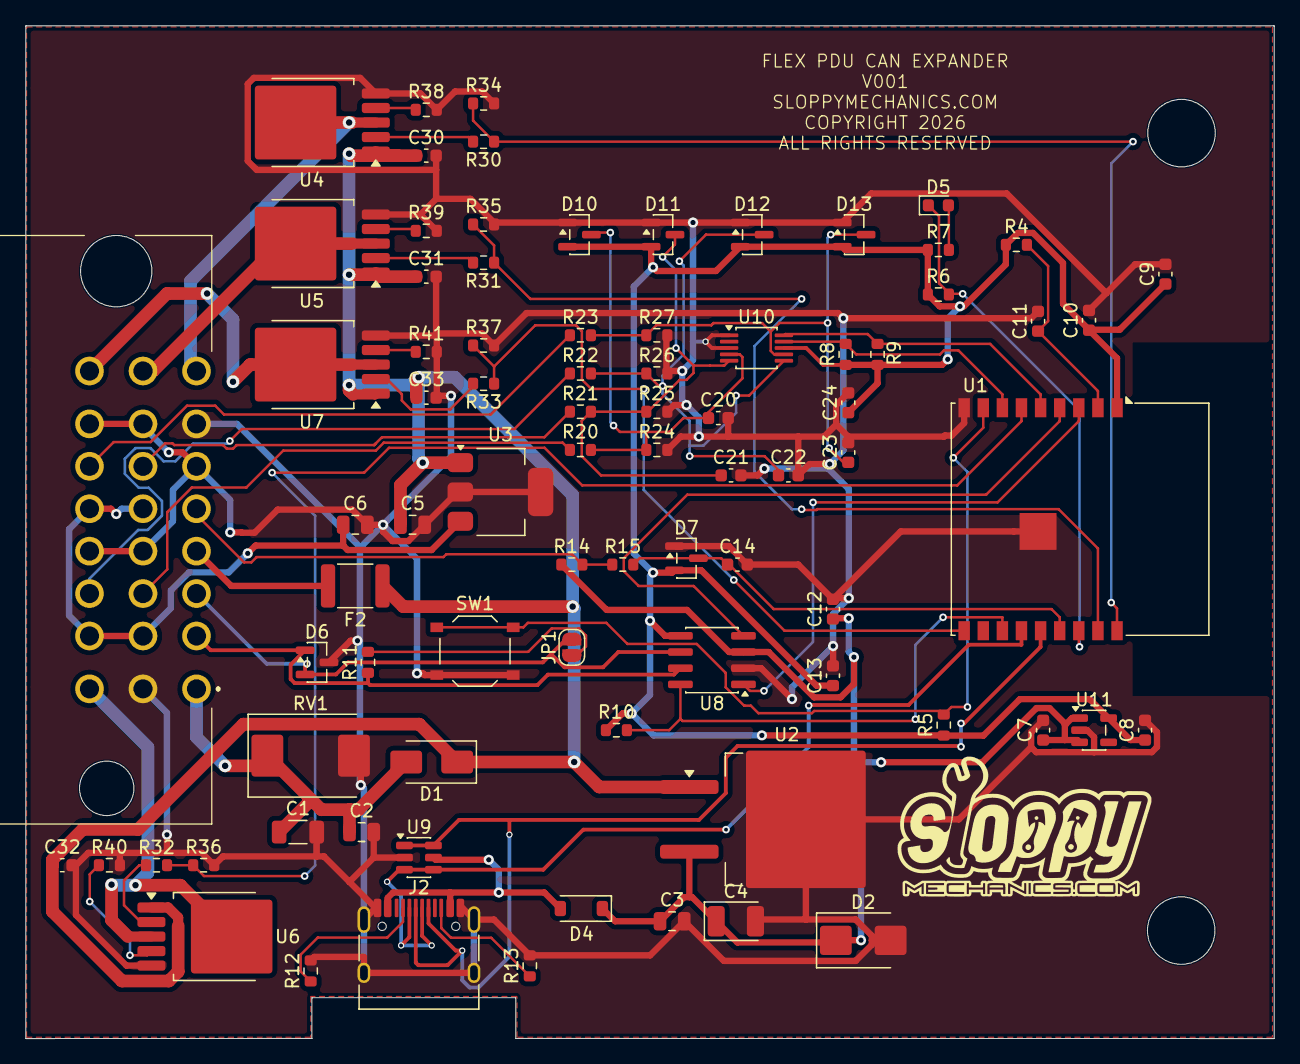
[picture p13: board Flex-over-can.kicad_pcb from above]

Board: 2 copper layers, 98.0 x 79.5 mm, 85 parts (0 on the bottom side), 51 nets.

Other parts of the board:
HOLE1, HOLE2: MountingHole_5.3mm_M5
