twisted-builds-llc/sloppy_holley_flex-over-can/(commit log)

2026-10-19 Add docs, PlatformIO firmware scaffold, fix KiCad lib paths
    - README, docs/PROGRESS.md, CAN_PROTOCOL.md, HARDWARE.md
    - firmware/: pinned pioarduino 55.03.311, no third-party libs.
    Flex -> device 1985 Input1/2, ADS1115 -> Input3-6 (hypothesis),
    Holley IO_OUTPUT rows -> 4 on/off outputs, serial bench commands.
    Native unit tests for holley.h.
    - KiCad lib tables use ${KIPRJMOD} instead of absolute Windows paths
    - Reference: Holley CAN docs, Ver12 PDU and Slim Ver5 prototypes
2026-10-19 Add WiFi web panel and NVS settings
    - web.h: AP panel (structure from Ver12) with status, AUTO/ALL OFF,
    30 s heartbeat-guarded output test, TX start/stop, Bench A test volts
    - settings.h: Holley row per output and WiFi password in NVS;
    per-board random password replaces the hardcoded Ver12 one
    - holley.h: test timer policy from Ver12 TestPolicy.h
2026-10-19 Add V001 schematic with Power and Connector sheets
    - Root sheet: ESP32-C3-MINI-1, ME6211 3V3, TPS7B6950 sensor 5V,
    TJA1051T/3 CAN, USB-C, flex input, ADS1115 analog, 4x BTS3256D outputs.
    - Power sheet: placeholder for own protection + 5V circuit
    (VBAT_IN/GND in, VBAT/+5V out).
    - Connector sheet: 24 harness pin stubs ending in no-connect flags.
    - Vendor Espressif KiCad lib 3.2.1 and custom FlexCAN symbols.
    - Docs: sheet table, LCSC part list, progress log.
2026-10-19 Split schematic into 10 US Letter sheets
    Move root circuitry into named hierarchical sheets: Supplies, MCU,
    USB, CAN, Flex, Analog and Outputs, alongside the existing Power and
    Connector sheets. Root now holds only sheet blocks and a page index.
    Cross-sheet nets use global labels. Netlist unchanged (74 parts,
    69 nets); ERC unchanged. Update the HARDWARE.md sheet table.
2026-10-19 Set ANALOG_SCALE to 1.6 for the V001 board
    The V001 analog inputs use a 12k/20k divider (x0.625), so connector
    volts = ADS1115 volts x 1.6. A bench breakout without the divider
    needs 1.0.
2026-10-23 Review power/connector sheets, fix ERC, add 3D models for all parts
    - Remove duplicate PWR_FLAG on +5V (ERC pin_to_pin error)
    - Register KiCad_Footprints and 24pinConnectorSymbol libs for J1
    - Correct D1 value to B160-13-F and RV1 to SMDJ24CA to match LCSC parts
    - C1: 10uF 50V X5R 1206 (C13585) for load-dump margin
    - F2: 0.2A/60V resettable PTC, Brightking SMD1812B020TF-J (C269125)
    - Add STEP models for J1, J2 (USB-C), SW1 (BOOT) and fix ESP32 model path
    - Project-local footprint copies carry the models for J2, SW1, F2
2026-10-23 Add PCB placement notes for decoupling caps to each sheet
2026-10-23 Fix stale J1 ground pin numbers in Outputs sheet note
2026-10-24 Update PCB layout and project settings
2026-10-24 Add Sloppy logo footprint
2026-10-24 Pre-order review: update docs to drawn power circuit and J1 cavities
    - README connector table now uses J1 cavity names (A1-C8)
    - HARDWARE.md: Power/Connector sheets as drawn, new parts, PCB V001
    summary, thermal/load-dump/output-current notes, current ERC/DRC state
    - PROGRESS.md: Phase 2/3 status, open pre-order items, review log
    - pins.h: flex pull-up comment matches board (5V pull-up, 3V3 clamp)
    - PCB: Update PCB from Schematic (symbol unit metadata only)
2026-10-24 Mark R38-R41 (SRP slew resistors) Do-not-populate
    R38-R41 only had a "DNP" text field, so BOM and CPL exports would have
    placed them. Set the real DNP attribute in the schematic and synced it
    to the PCB. KiCad's save also normalized the sheets to LF line endings
    and reformatted text notes; no other design changes.
2026-10-24 Add Freerouting DSN/SES files; ignore KiCad local history
2026-10-25 Update PCB layout, MCU schematic, and routing; add fab outputs
    Add fabrication-toolkit options and production/ package (BOM, CPL,
    designators, IPC netlist, gerber zip).
2026-10-27 3D file for print testing.
2026-11-01 changed KiCad design for USB connection.
2026-11-01 Docs: ESP32-C3-WROOM-02, USB-C notch, 2026-11-01 pre-order check
    Correct U1 to ESP32-C3-WROOM-02-N4 (C2934560) to match the schematic,
    footprint and BOM. Record the J2 edge-notch move, DRC/ERC/Gerber/firmware
    re-check results, and the remaining open items (U2 thermal vias,
    JP1/NT1 do-not-place at JLC).
