twisted-builds-llc/sloppy_holley_flex-over-can/(notices)

Notices in the files:
Sloppy_Holley_Flex-over-can/Flex-over-can/Flex-over-can.kicad_pcb:
COPYRIGHT 2026
ALL RIGHTS RESERVED
